kirisaki/TinyTR/(commit log)

2026-01-12 Add initial project structure for TinyTR drum machine
    - Add firmware for synthesizer (ATtiny85 sound generation)
    - Add firmware stub for sequencer (ATtiny85 pattern control)
    - Add license files (MIT/Apache-2.0, CERN-OHL-P, CC-BY-SA)
    - Add project README
    - Add .gitignore for AVR, KiCad, and Python/build123d
2026-01-12 feat(hardware): Create schematic based on current circuit
    [tiny_tr.kicad_pcb, tiny_tr.kicad_sch]
2026-01-12 docs: Add complete architecture design document
    - Document modular synthesizer/sequencer architecture
    - Specify pin assignments for both ATtiny85 chips
    - Define CV protocol: PWM voltage for trigger+accent (0-5V)
    - Document 16-step pattern structure
    - Describe I2C tempo synchronization for multi-unit setup
    - Add button input design with resistor divider
    - Mark resolved design decisions and development progress
2026-01-12 docs: Update synthesizer pin assignment and hardware details
    Sequencer changes:
    - Replace PB4 potentiometer with LED indicator
    - Clarify button functions for value adjustment
    - Move all parameter control to button interface
    Synthesizer changes:
    - Add planned pin assignment using PB1 for audio (OC1A)
    - Free up PB4 for CV input (ADC2)
    - Add DECAY/TONE potentiometers on PB2/PB3
    - Keep RESET functional for ISP programming
    - Document current implementation separately
    - Add analog post-processing circuits (resonance/distortion)
    - Specify NJM2746M dual op-amp for analog circuits
2026-01-23 feat(synthesizer): Add potentiometer control for DECAY and TONE
    - Add ADC reading for PB2 (DECAY) and PB3 (TONE) potentiometers
    - Add configurable param_decay and param_tone global variables
    - Link pitch sweep end point to param_tone (ratio 1:20)
    - Simplify test pattern to kick-only four-on-the-floor at 120 BPM
    - Read pots continuously during playback for real-time control
2026-01-23 refactor(synthesizer): Change PWM output from PB4 to PB1
    - Move audio output from OC1B (PB4) to OC1A (PB1)
    - Update Timer1 config: use TCCR1 for OC1A settings
    - voices.h: OCR1B -> OCR1A
    - Remove LED blink code from trigger functions
    - Frees up PB4 for CV input (ADC2)
2026-01-23 feat(synthesizer): Implement CV input for trigger and accent
    - Add ADC reading on PB4 (ADC2) for CV input
    - Trigger kick on rising edge (CV > 0.4V)
    - Reset trigger when CV drops below 0.1V (hysteresis)
    - Scale volume by CV voltage for accent control
    [main.c]
2026-01-23 fix(synthesizer): Use cli/sei for atomic 16-bit variable updates
    Disable interrupts during trigger to prevent ISR from reading
    partially written 16-bit values (k_vol, k_step, k_phase).
    This fixes the issue where kick attack was sometimes missing.
    [main.c]
2026-01-23 feat(synthesizer): Restore accent control from CV voltage
    Scale volume based on CV input (50-100% range).
    Higher CV voltage = louder sound.
2026-01-23 docs(sequencer): Add I2C sync protocol details
    - Define standalone/primary/secondary states
    - Document state transitions for tempo sync
    - Use broadcast-only protocol (no addressing needed)
    - Update terminology to primary/secondary
2026-01-26 fix(synthesizer): Reduce click artifacts in kick drum
    - Change initial phase from 0xC000 to 0x6000 (start at trough)
    to avoid sudden jump from 0 to ~122 at trigger
    - Constrain param_decay to 2^n-1 values (1,3,7) to prevent
    irregular decay timing that causes 2.5kHz modulation noise
    - Narrow TONE range from 500-2500 to 700-1700 to avoid artifacts
    at extreme low frequencies
    [main.c, test.c, voices.h]
2026-01-26 fix(hardware): Update capacitor values for noise reduction
    [tiny_tr.kicad_sch]
2026-01-26 fix(hardware): Increase PAM8302 bypass capacitor to 100uF
    Prevents voltage droop during kick attack that was causing
    power rail fluctuations.
    [tiny_tr.kicad_sch]
2026-01-26 feat(synthesizer): Add voice selection and new sounds
    - Add voice selection button on PB0 with internal pull-up
    - Add tom drum (sine wave with pitch sweep, faster decay than kick)
    - Add cowbell (two detuned oscillators at 587Hz/845Hz)
    - Improve snare with tonal body component (~180Hz)
    - Update main.c and test.c to support 6 voices with accent
    Voices: kick, snare, hihat, clap, tom, cowbell
    [main.c, test.c, voices.h]
2026-01-26 feat(hardware): Add voice selection button on PB0
    - Add button connected to pin 5 (PB0) with internal pull-up
    - Remove unnecessary external pull-up resistor
    [tiny_tr.kicad_sch]
2026-01-26 feat(synthesizer): Add DECAY/TONE control to all voices and improve clap
    - Apply param_decay and param_tone to all 6 voices
    - Kick/Tom: pitch and decay control
    - Snare: body pitch and decay control
    - Hi-hat/Clap: decay control
    - Cowbell: pitch shift and decay control
    - Add stutter effect to clap (3 bursts) for more realistic sound
2026-01-26 feat(synthesizer): Improve sound quality and add DECAY/TONE pot control
    - Add ADC reading for DECAY (PB2) and TONE (PB3) potentiometers
    - Add 100us settling time after ADC channel switch
    - Adjust CV thresholds (10/3) and accent volume mapping
    - Rename static div variables to unique names per voice function
    - Add phase offset to cowbell for metallic attack sound
    - Adjust decay range (3,7,15) and tone base frequency (470)
2026-01-26 feat(synthesizer): Add per-voice tuning constants and finer snare noise
    - Add tuning constants section for easy adjustment:
    - Initial volumes: K/S/H/C/T/CB_VOL_INIT
    - Decay rate shifts: K/S/H/C/T/CB_DECAY_SHIFT
    - Add per-voice decay variables (k_decay, s_decay, etc.)
    - Map param_decay to each voice with appropriate scaling
    - Change snare noise from 1-bit to 8-bit (256 levels) for finer grain
    - Adjust kick decay (faster), snare noise vol (lower), hihat vol (subtler)
    [main.c, voices.h]
2026-01-26 feat(synthesizer): Improve kick drum sound quality
    - Add proportional pitch sweep (fast at high pitch, slow at low)
    to reduce stepping artifacts at low frequencies
    - Add light low-pass filter (50/50) to smooth high frequency content
    - Start kick phase at zero-crossing for cleaner attack
2026-01-26 feat(synthesizer): Add metallic character to hi-hat
    - Add two high-frequency square wave oscillators (2740Hz / 3560Hz)
    - XOR oscillators for metallic timbre
    - Blend with 7-bit noise for hi-hat character
    - Softer attack (no phase offset)
    [voices.h]
2026-01-28 feat(sequencer): Add CV output test and fuse configuration
    - Add test.c with 16-step pattern sequencer for CV testing
    - Add fuse target to both Makefiles for 8MHz oscillator setup
    - Update DESIGN.md: swap PB3/PB4 for sequencer (CV needs OC1B on PB4)
    - LED blinks on quarter notes, CV outputs PWM with RC filter
    [test.c]
2026-01-28 docs(design): Finalize sequencer UI with 3-button system
    - 3 buttons: A (ON/Save), B (OFF/Clear), Mode (cycle/I2C master)
    - 5 modes: Play, Tempo, Bank, LFO Rate, LFO Depth
    - 8 pattern banks with EEPROM storage (16 bytes)
    - LED feedback per mode (alternating, flash, solid, LFO blink, PWM)
    - Button resistor divider: 10k pull-up, 0/2.2k/4.7k to GND
    - Add mute.c and update test.c with hi-hat pattern
2026-01-28 fix(sequencer): Correct pin assignment for ADC button input
    - PB1: LED (GPIO, no ADC on this pin)
    - PB3: Button input (ADC3)
    - PB4: CV output (OC1B PWM, unchanged)
    Add button test with pattern switching:
    - A: Funky hi-hat pattern
    - B: 4-on-the-floor pattern
    - M: Mute
    [test.c]
2026-01-28 feat(hardware): Add sequencer circuit to schematic
    [tiny_tr.kicad_sch]
2026-01-28 feat(firmware): Implement sequencer Play mode and fix synthesizer issues
    Sequencer:
    - Add 16-step pattern editing in Play mode
    - LED brightness indicates beat position (beat 1 bright, beat 3 dim)
    - Hold A to add notes, hold B to remove notes during playback
    Synthesizer:
    - Prioritize CV reading for responsive triggering
    - Fix clap rapid-fire causing harsh sound (skip stutter on retrigger)
    - Avoid kick click on retrigger (don't reset phase)
    - Check voice button more frequently (every 16 loops vs 256)
    [main.c]
2026-01-28 fix(hardware): Add 10nF debounce capacitor to sequencer button input
    [tiny_tr.kicad_sch]
2026-01-28 feat(sequencer): Immediate CV response to button during playback
    Button state now directly controls CV output in ISR:
    - A held: play step AND add to pattern
    - B held: mute step AND remove from pattern
    This allows real-time muting/adding while pattern plays.
2026-01-28 feat(sequencer): Auto-save pattern to EEPROM at bar end
    - Save pattern automatically when bar loops (step 15→0)
    - Use magic byte (0xA5) to detect first boot vs valid data
    - Only saves when pattern actually changed (dirty flag)
2026-01-28 docs(design): Update sequencer progress and plan EEPROM wear leveling
    - Update Play mode: hold-to-edit with immediate CV response
    - Add EEPROM wear leveling design (rotating slots, 170× lifespan)
    - Mark completed Phase 2 items
2026-01-28 feat(sequencer): Expand to 32-step pattern with improved LED feedback
    - 32 steps (2 bars) instead of 16
    - LED: quarter note blink, bar 2 beat 1 uses 8th notes to distinguish
    - Pattern stored as uint32_t (4 bytes)
    - Update EEPROM to use dword read/write
    - Update wear leveling calculations in docs
2026-01-29 refactor(synthesizer): Extract common hardware code to hardware.h
    Move shared code between main.c and test.c into hardware.h:
    - Pin definitions (SPEAKER_PIN, CV_INPUT_CH, DECAY_CH, TONE_CH)
    - read_adc() function
    - setup_hardware() function (Timer/PLL/ADC initialization)
2026-01-29 refactor(synthesizer): Add accent-aware trigger functions
    - Add trigger_*_accent() functions for CV-controlled volume
    - Add scale_vol() helper for volume scaling
    - Add trigger_current_voice_with_accent() for unified trigger
    - Simplify main.c trigger handling from 40-line switch to 1-line call
    - Existing trigger_*() functions now wrap accent versions
2026-01-29 refactor(synthesizer): Extract LFSR noise generation to noise_step()
    Consolidate duplicate LFSR code from calc_snare, calc_hihat, calc_clap
    into a single inline function.
    [voices.h]
2026-01-29 refactor: Extract ADC code to common/adc.h
    Share ADC initialization and read functions between synthesizer and
    sequencer to eliminate code duplication.
2026-01-29 refactor(sequencer): Extract ISR logic into separate functions
    - Add update_led() for LED control logic
    - Add update_cv() for CV output and pattern update
    - Add CV_GATE_MS constant (replaces magic number 10)
    - ISR now calls helper functions for cleaner code
    [main.c]
2026-01-29 docs: Fix documentation inconsistencies with code
    - Remove outdated "Current Implementation" pin assignment
    - Update pattern size: 16 steps → 32 steps
    - Update EEPROM size: 2 bytes → 4 bytes per bank
    - Add tom and cowbell to README voice list
    - Add Q&A about why two ATtiny85s (stock clearance)
2026-02-02 feat(sequencer): Add pattern bank selection and 2-layer mode system
    - Add 8 pattern banks with EEPROM storage
    - Implement 2-layer mode system:
    - Main layer: Play ↔ Bank (M short press toggle)
    - Settings layer: Tempo → LFO Rate → LFO Depth → I2C (M short press cycle)
    - M long press switches between layers
    - Bank switching scheduled at bar start (step 0) for seamless transitions
    - Add software debounce (3 consecutive readings required)
    - Update button thresholds for better noise immunity
    - Bank mode LED pattern: inverted from Play (same bar head, rest inverted)
    - Update DESIGN.md with new mode system and implementation details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
    [main.c]
2026-02-02 fix(sequencer): Apply bank switch immediately when returning to Play mode
    - Apply pending bank switch when entering Play mode from Bank or Settings
    - This ensures editing targets the correct bank after selection
    - Reduce pattern clear hold time from 2s to 1.2s
    [main.c]
2026-02-02 fix(sequencer): Block pattern editing during pending bank switch
    - Block A/B pattern editing while bank switch is pending
    - Block B long-press clear while bank switch is pending
    - Ensures sound and editing target are always in sync
    - Reverts immediate bank switch on Play mode entry
    [main.c]
2026-02-02 docs: Rename I2C mode to Etc mode and document new functions
    - Rename MODE_I2C to MODE_ETC (miscellaneous settings mode)
    - Document Etc mode functions:
    - A long press: Toggle I2C master mode
    - B long press: Clear all 8 banks (full reset)
    - Play mode B long press remains for current bank clear only
    - Update mode table with A Long / B Long columns
    [main.c]
2026-02-02 feat(sequencer): Implement Tempo mode with BPM control
    - Add variable BPM (60-240, 5 step increments)
    - Tempo mode: A=BPM down, B=BPM up
    - Hold button for continuous change (200ms repeat)
    - Save BPM to EEPROM when leaving Tempo mode
    - Load BPM from EEPROM on startup
2026-02-02 fix(sequencer): Improve Tempo mode LED to flash on every beat
    - Flash LED on every beat (steps 0,4,8,12,16,20,24,28)
    - Makes tempo easier to follow visually
    [main.c]
2026-02-18 docs: Sync DESIGN.md and code comments with current implementation
    Update documentation to match actual firmware state:
    - Mark I2C pins as reserved/unused, Etc mode and LFO as planned
    - Fix Tempo LED description, debounce capacitor, long press timings
    - Add BPM to EEPROM layout, update Tempo control details
    - Check off Tempo control in Phase 2, move Current marker
    - Fix accent volume max in synthesizer code comment (65535→65384)
    [main.c]
